pastcompute/sentrifarm/attic/experiments/solar430/logger2.jpg

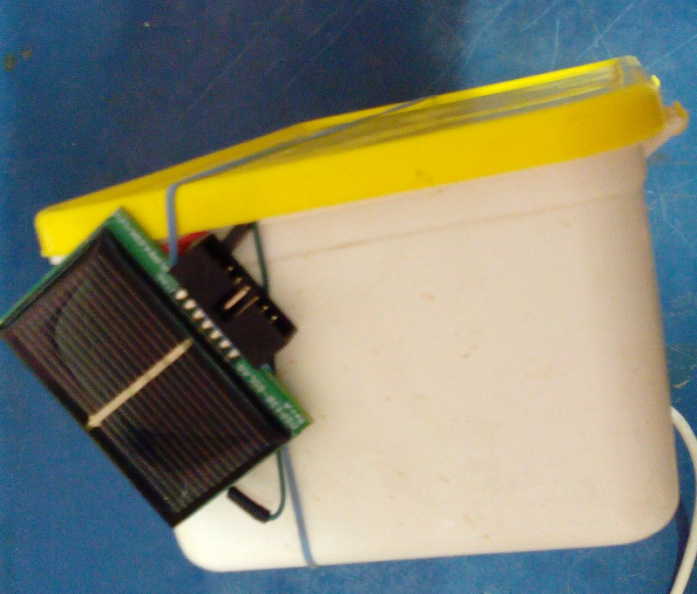
attic/experiments/solar430/logger2.jpg
