pastcompute/sentrifarm/attic/experiments/solar430/logger1.jpg

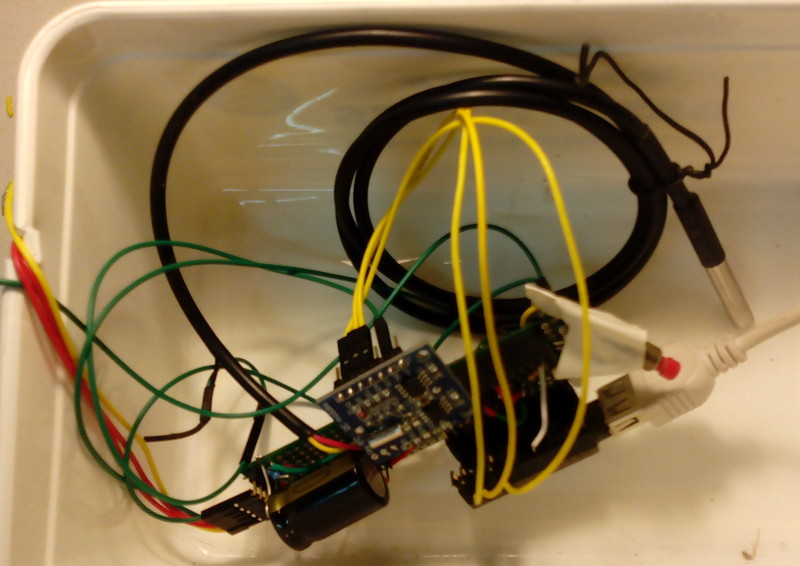
attic/experiments/solar430/logger1.jpg
