pastcompute/sentrifarm/attic/ground-sensor/README.md

# Farmer Stay In bed?

This is the ground sensor subsystem (requirements, schematics, code)
