pastcompute/sentrifarm/attic/frankenstein.md

Needs submnodule. Removed to make gh page in docs/ build

  1 #[submodule "frankenstein"]
  2 #       path = attic/ground-sensor/code/frankenstein
  3 #       url = https://github.com/pastcompute/esp8266-frankenstein.git
