pastcompute/sentrifarm/media/ArtisticImpression.png

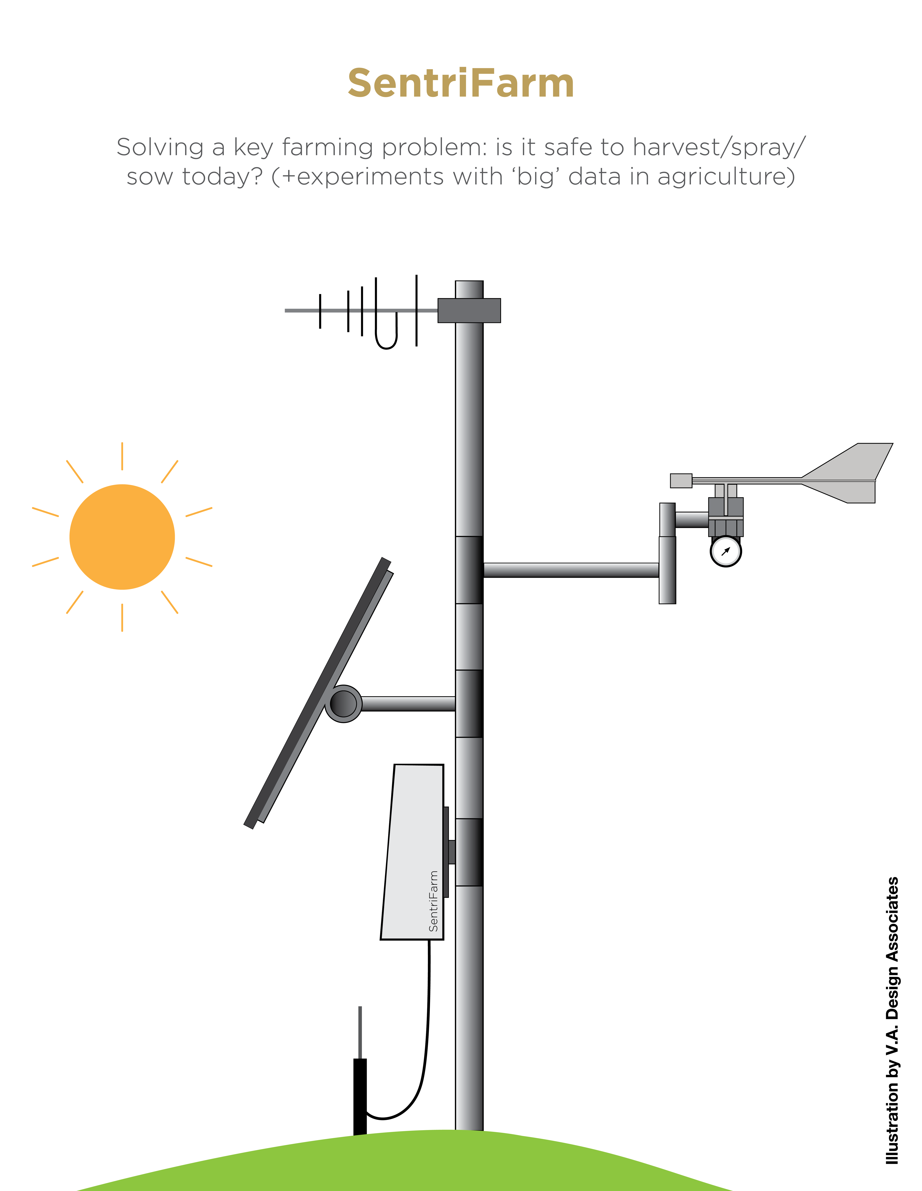
media/ArtisticImpression.png
