pastcompute/sentrifarm/media/birdnest.jpg

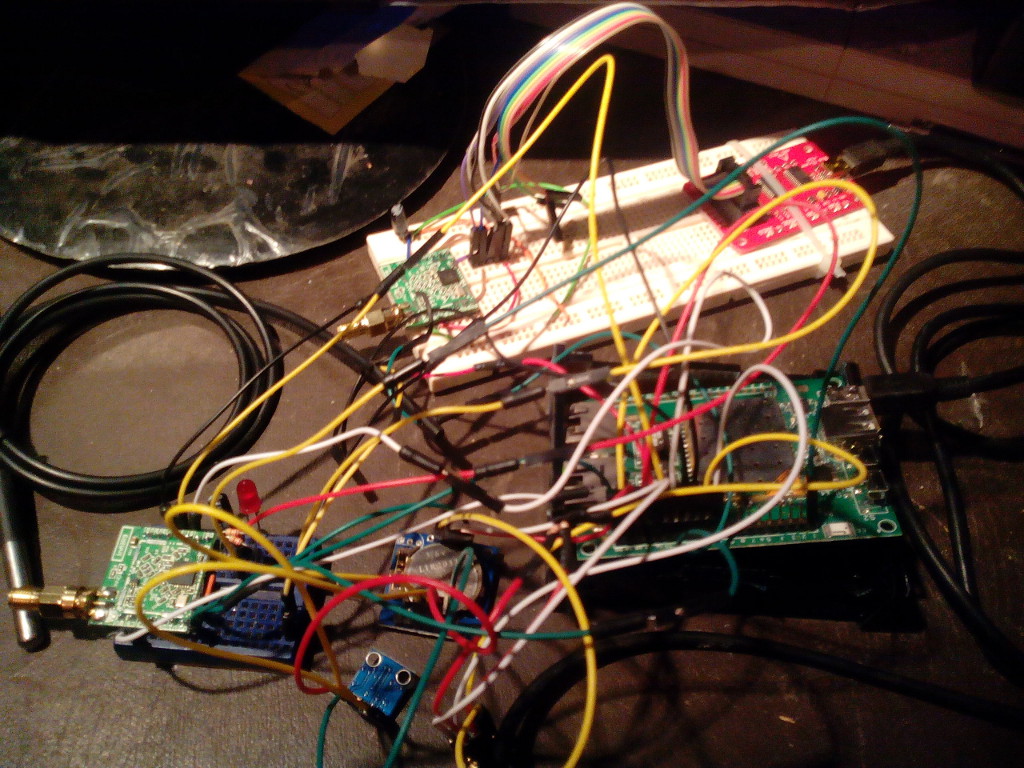
media/birdnest.jpg
