pastcompute/sentrifarm/media/buspirate-sx1276.jpg

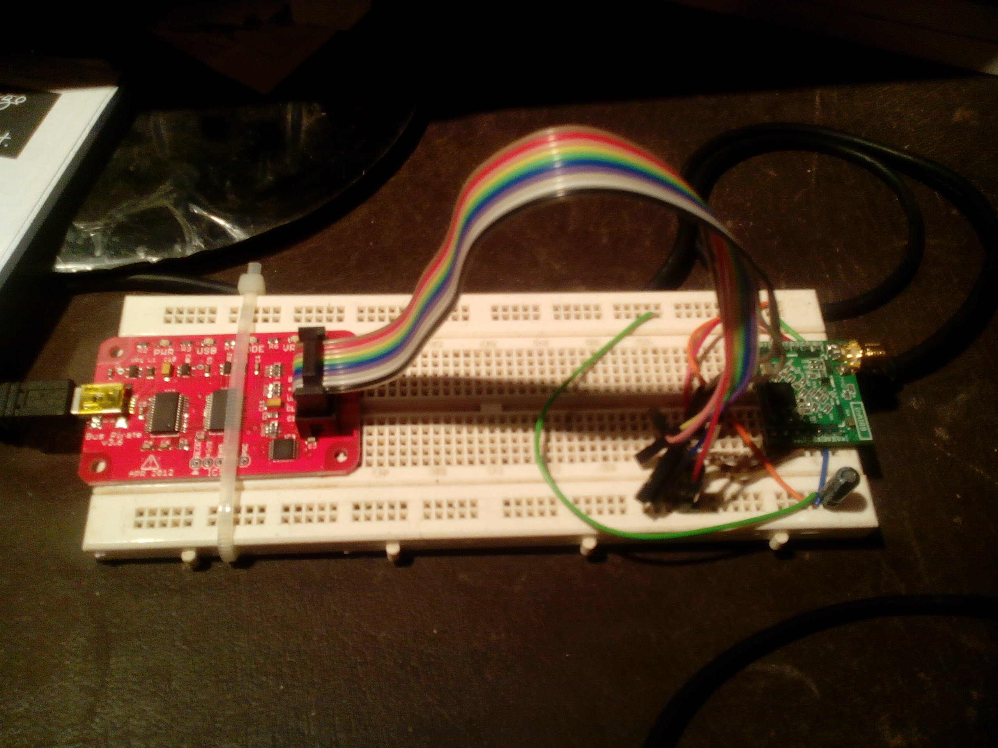
media/buspirate-sx1276.jpg
