pastcompute/sentrifarm/media/HighLevelDesignv0.png

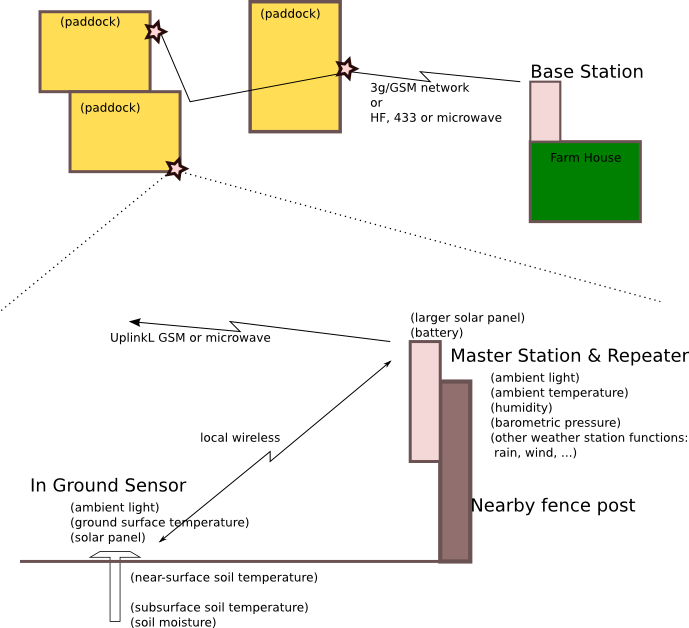
media/HighLevelDesignv0.png
