pastcompute/sentrifarm/attic/experiments/solar430/third-logging-run.ods

 | Time | Vsolar | Vcap | Vregin | Icap mA | Charge | Vregout | TempC
2015-04-10 18:21:13 | 18:21 | 2556 | 2052 | 2057 | 0.13 | 45.14 | 3289 | 16.00
2015-04-10 18:26:13 | 18:26 | 2223 | 2047 | 2038 | -0.23 | 45.03 | 3299 | 15.75
2015-04-10 18:31:13 | 18:31 | 2135 | 2038 | 2033 | -0.13 | 44.84 | 3284 | 15.50
2015-04-10 18:36:14 | 18:36 | 2174 | 2033 | 2023 | -0.26 | 44.73 | 3279 | 15.25
2015-04-10 18:41:14 | 18:41 | 2082 | 2028 | 2018 | -0.26 | 44.62 | 3279 | 15.25
2015-04-10 18:46:14 | 18:46 | 1984 | 2018 | 2008 | -0.26 | 44.40 | 3279 | 15.00
2015-04-10 18:51:14 | 18:51 | 1979 | 2013 | 2003 | -0.26 | 44.29 | 3279 | 15.00
2015-04-10 18:56:15 | 18:56 | 1989 | 2008 | 1999 | -0.23 | 44.18 | 3279 | 15.00
2015-04-10 19:01:15 | 19:01 | 2096 | 2008 | 1994 | -0.36 | 44.18 | 3279 | 14.75
2015-04-10 19:06:15 | 19:06 | 2067 | 1994 | 1984 | -0.26 | 43.87 | 3279 | 14.75
2015-04-10 19:11:16 | 19:11 | 2057 | 1989 | 1979 | -0.26 | 43.76 | 3279 | 14.50
2015-04-10 19:16:16 | 19:16 | 2013 | 1994 | 1974 | -0.51 | 43.87 | 3279 | 14.50
2015-04-10 19:21:16 | 19:21 | 2028 | 1979 | 1969 | -0.26 | 43.54 | 3279 | 14.50
2015-04-10 19:26:16 | 19:26 | 1984 | 1974 | 1959 | -0.38 | 43.43 | 3279 | 14.25
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
