pastcompute/sentrifarm/attic/experiments/solar430/first-logging-run.ods

 | Time |  | Vsolar | Vcap | Vdin | Icap uA | Vreg | Temp
2015-04-04 22:46:29 | 10:46 PM | 10.428 | 0 | 474 | 474 | 0.00 | 474 | 19.75
2015-04-04 22:51:30 | 10:51 PM | 10.516 | 0 | 478 | 478 | 0.00 | 478 | 18.25
2015-04-04 22:56:30 | 10:56 PM | 10.516 | 0 | 478 | 478 | 0.00 | 478 | 17.5
2015-04-04 23:01:30 | 11:01 PM | 10.626 | 0 | 483 | 483 | 0.00 | 483 | 17.25
2015-04-04 23:06:30 | 11:06 PM | 10.626 | 0 | 483 | 483 | 0.00 | 483 | 17
2015-04-04 23:11:31 | 11:11 PM | 10.626 | 0 | 483 | 488 | 73.53 | 483 | 16.75
2015-04-04 23:16:31 | 11:16 PM | 10.626 | 0 | 483 | 488 | 73.53 | 483 | 16.5
2015-04-04 23:21:31 | 11:21 PM | 10.736 | 0 | 488 | 488 | 0.00 | 488 | 16.5
2015-04-04 23:26:32 | 11:26 PM | 10.736 | 0 | 488 | 493 | 73.53 | 488 | 16.25
2015-04-04 23:31:32 | 11:31 PM | 10.736 | 0 | 488 | 493 | 73.53 | 488 | 16
2015-04-04 23:36:32 | 11:36 PM | 10.846 | 0 | 493 | 493 | 0.00 | 488 | 16
2015-04-04 23:41:32 | 11:41 PM | 10.846 | 0 | 493 | 493 | 0.00 | 493 | 15.75
2015-04-04 23:46:33 | 11:46 PM | 10.846 | 0 | 493 | 493 | 0.00 | 493 | 15.75
2015-04-04 23:51:33 | 11:51 PM | 10.846 | 0 | 493 | 498 | 73.53 | 493 | 15.75
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
