pastcompute/sentrifarm/attic/experiments/solar430/second-logging-run.ods

 |  | Vsolar | Vcap | Vregin | Icap mA | Charge | Vregout | TempC
2015-04-10 15:53:41 | 15:53 | 562 | 322 | 371 | 1.26 | 7.08 | 552 | 19.75 | 0.154
2015-04-10 15:54:14 | 15:54 | 2326 | 337 | 2047 | 43.85 | 7.41 | 3274 | 20 | 0.161173913
2015-04-10 15:54:22 | 15:54 | 2326 | 351 | 2043 | 43.38 | 7.72 | 3260 | 20.25 | 0.1678695652
2015-04-10 15:54:50 | 15:54 | 2341 | 410 | 2057 | 42.23 | 9.02 | 3279 | 20.75 | 0.1960869565
2015-04-10 15:55:36 | 15:55 | 2287 | 488 | 2013 | 39.10 | 10.74 | 3235 | 21.5 | 0.2333913043
2015-04-10 15:56:01 | 15:56 | 2292 | 527 | 2033 | 38.62 | 11.59 | 3255 | 22 | 0.2520434783
2015-04-10 15:56:09 | 15:56 | 2306 | 542 | 2038 | 38.36 | 11.92 | 3255 | 22.25 | 0.2592173913
2015-04-10 15:56:13 | 15:56 | 2262 | 547 | 1999 | 37.23 | 12.03 | 3255 | 22.25 | 0.2616086957
2015-04-10 15:56:18 | 15:56 | 2336 | 557 | 2067 | 38.72 | 12.25 | 3250 | 22.25 | 0.2663913043
2015-04-10 15:56:23 | 15:56 | 2321 | 566 | 2062 | 38.36 | 12.45 | 3250 | 22.25 | 0.2706956522
2015-04-10 15:56:29 | 15:56 | 2238 | 576 | 1979 | 35.97 | 12.67 | 3255 | 22.5 | 0.2754782609
2015-04-10 15:56:34 | 15:56 | 2194 | 581 | 1930 | 34.59 | 12.78 | 3235 | 22.5 | 0.2778695652
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
