pastcompute/sentrifarm/attic/experiments/solar430/chart-1.png

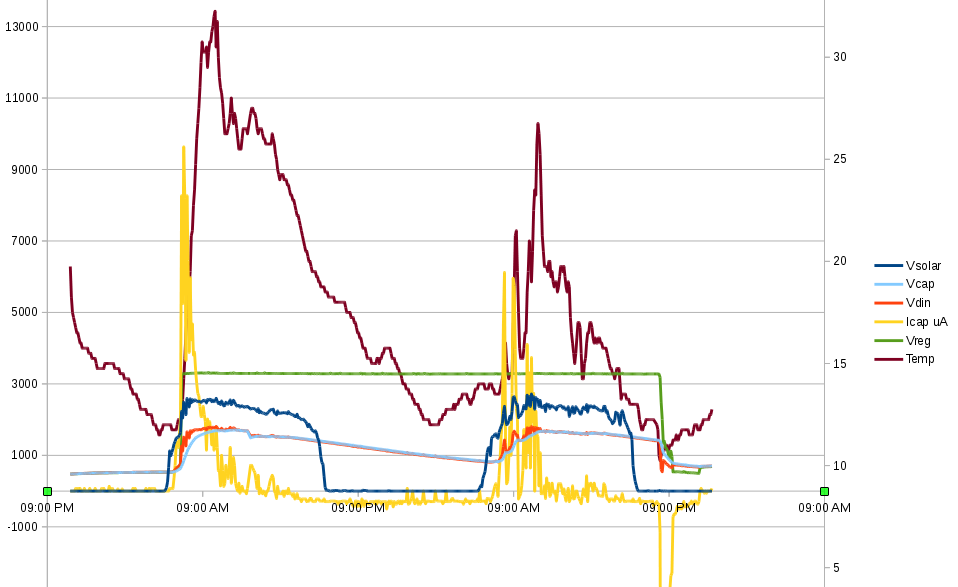
attic/experiments/solar430/chart-1.png
