pastcompute/sentrifarm/attic/experiments/solar430/chart-2a.png

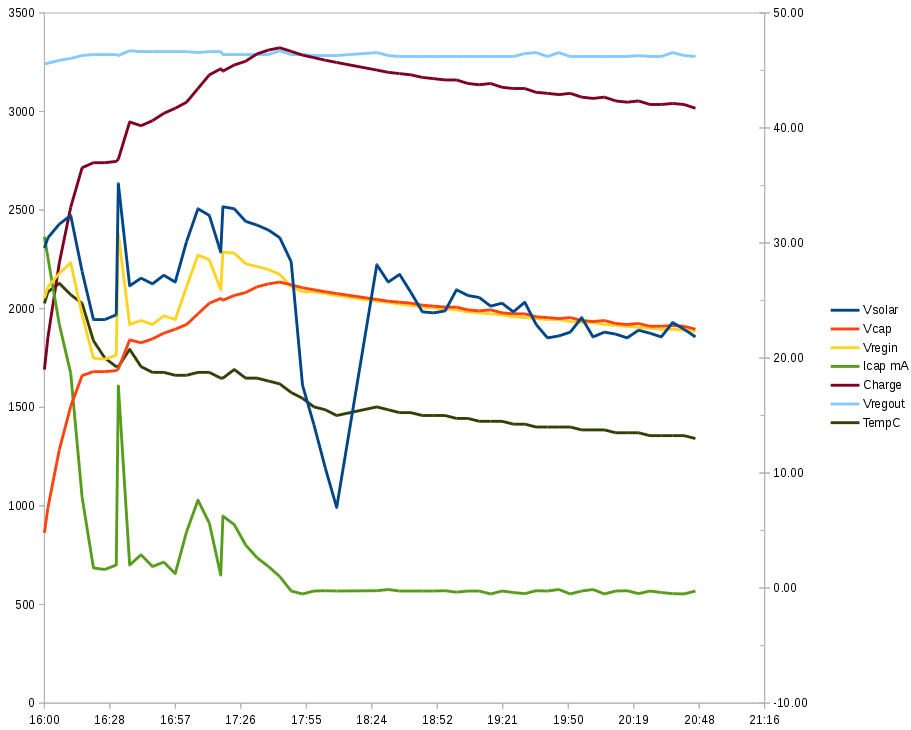
attic/experiments/solar430/chart-2a.png
