pastcompute/sentrifarm/attic/experiments/solar430/chart-3a.png

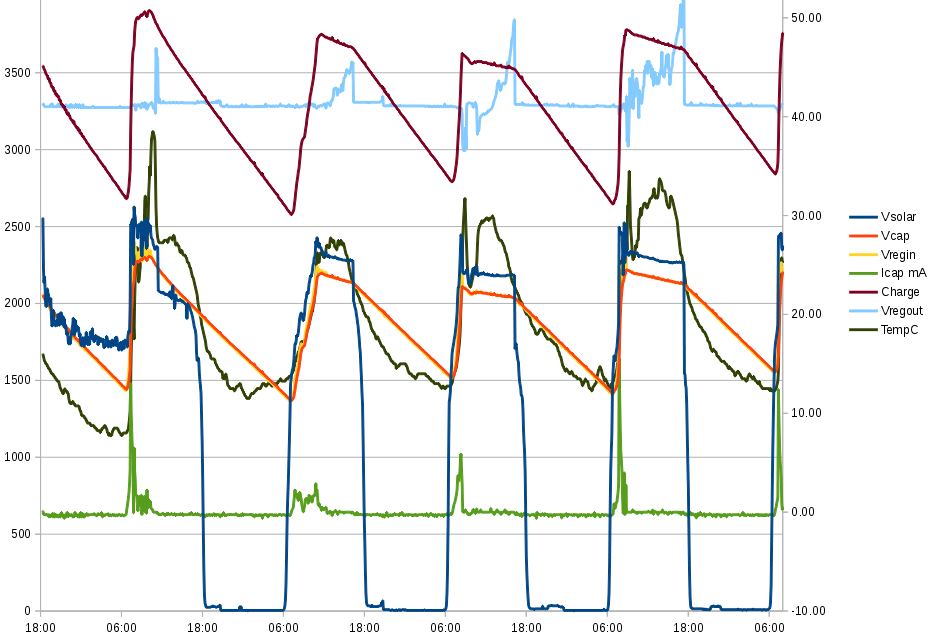
attic/experiments/solar430/chart-3a.png
