pastcompute/sentrifarm/hardware/carambola2-inair9-io-shield/ioshield.pdf

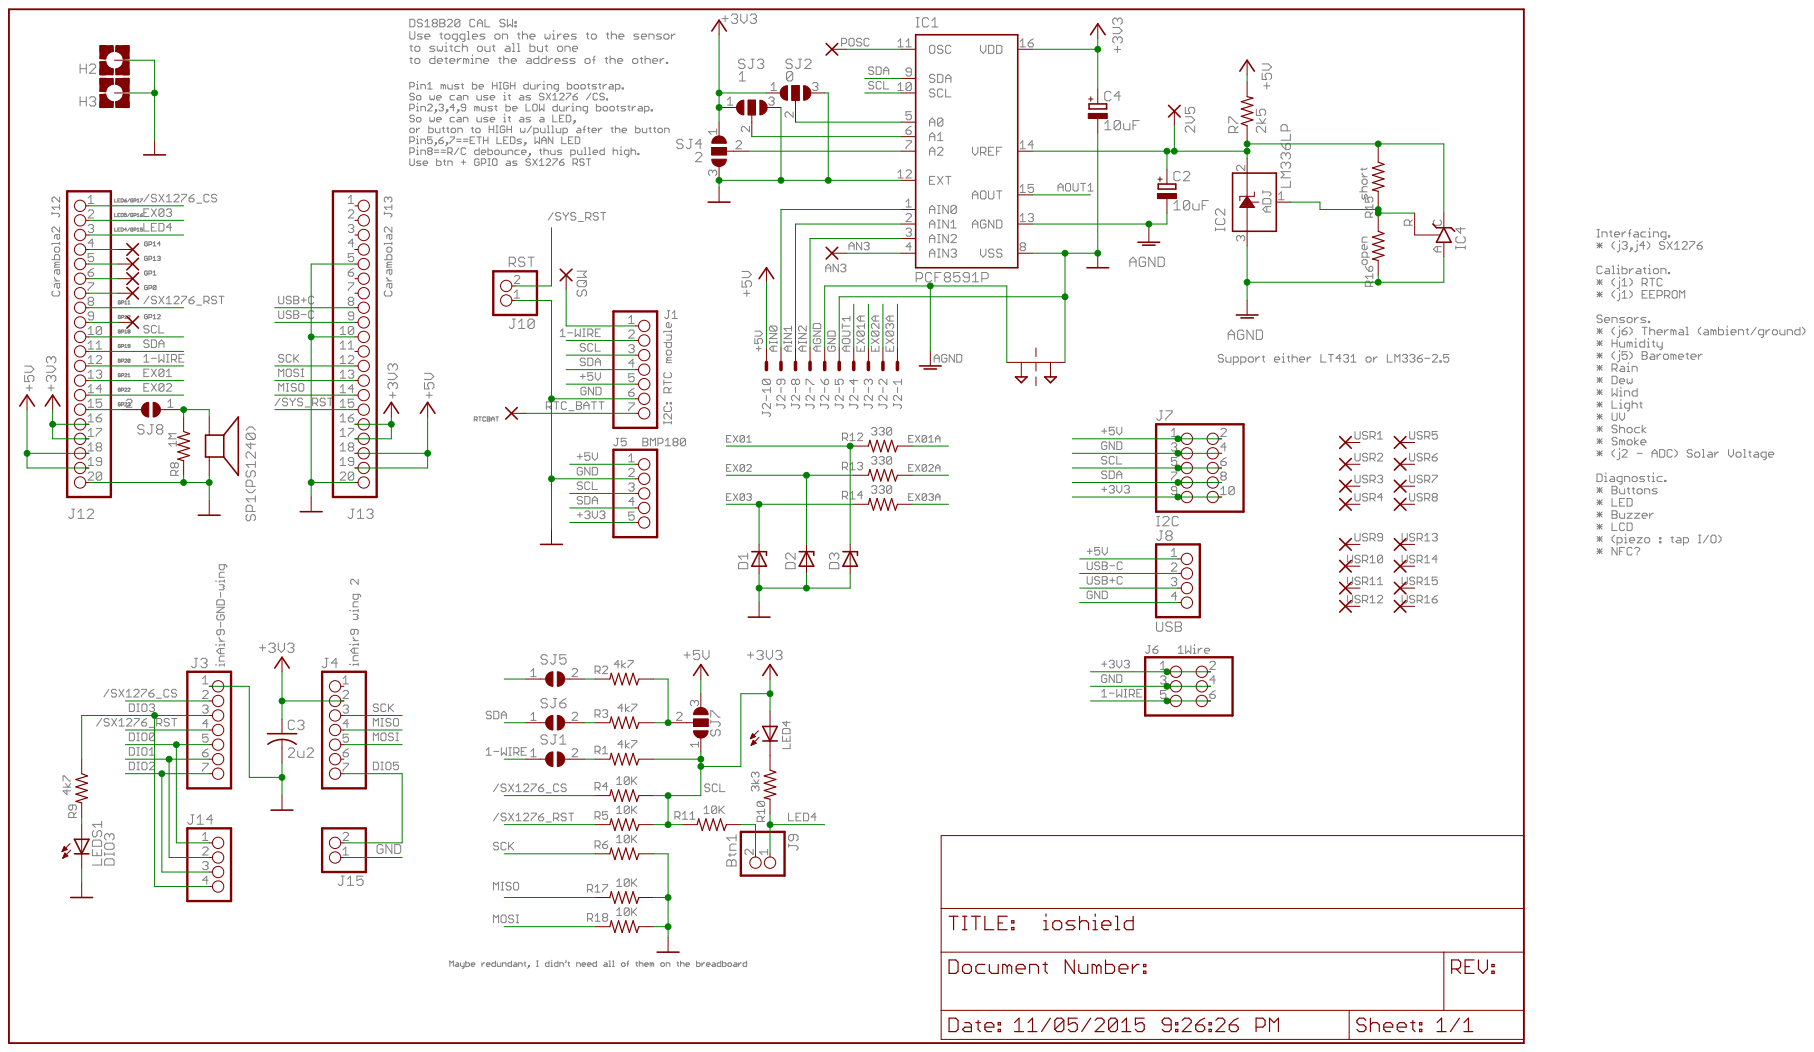
[picture p10: page 1]
