pastcompute/sentrifarm/hardware/inair9-ioshield-adaptor/ioshield.pdf

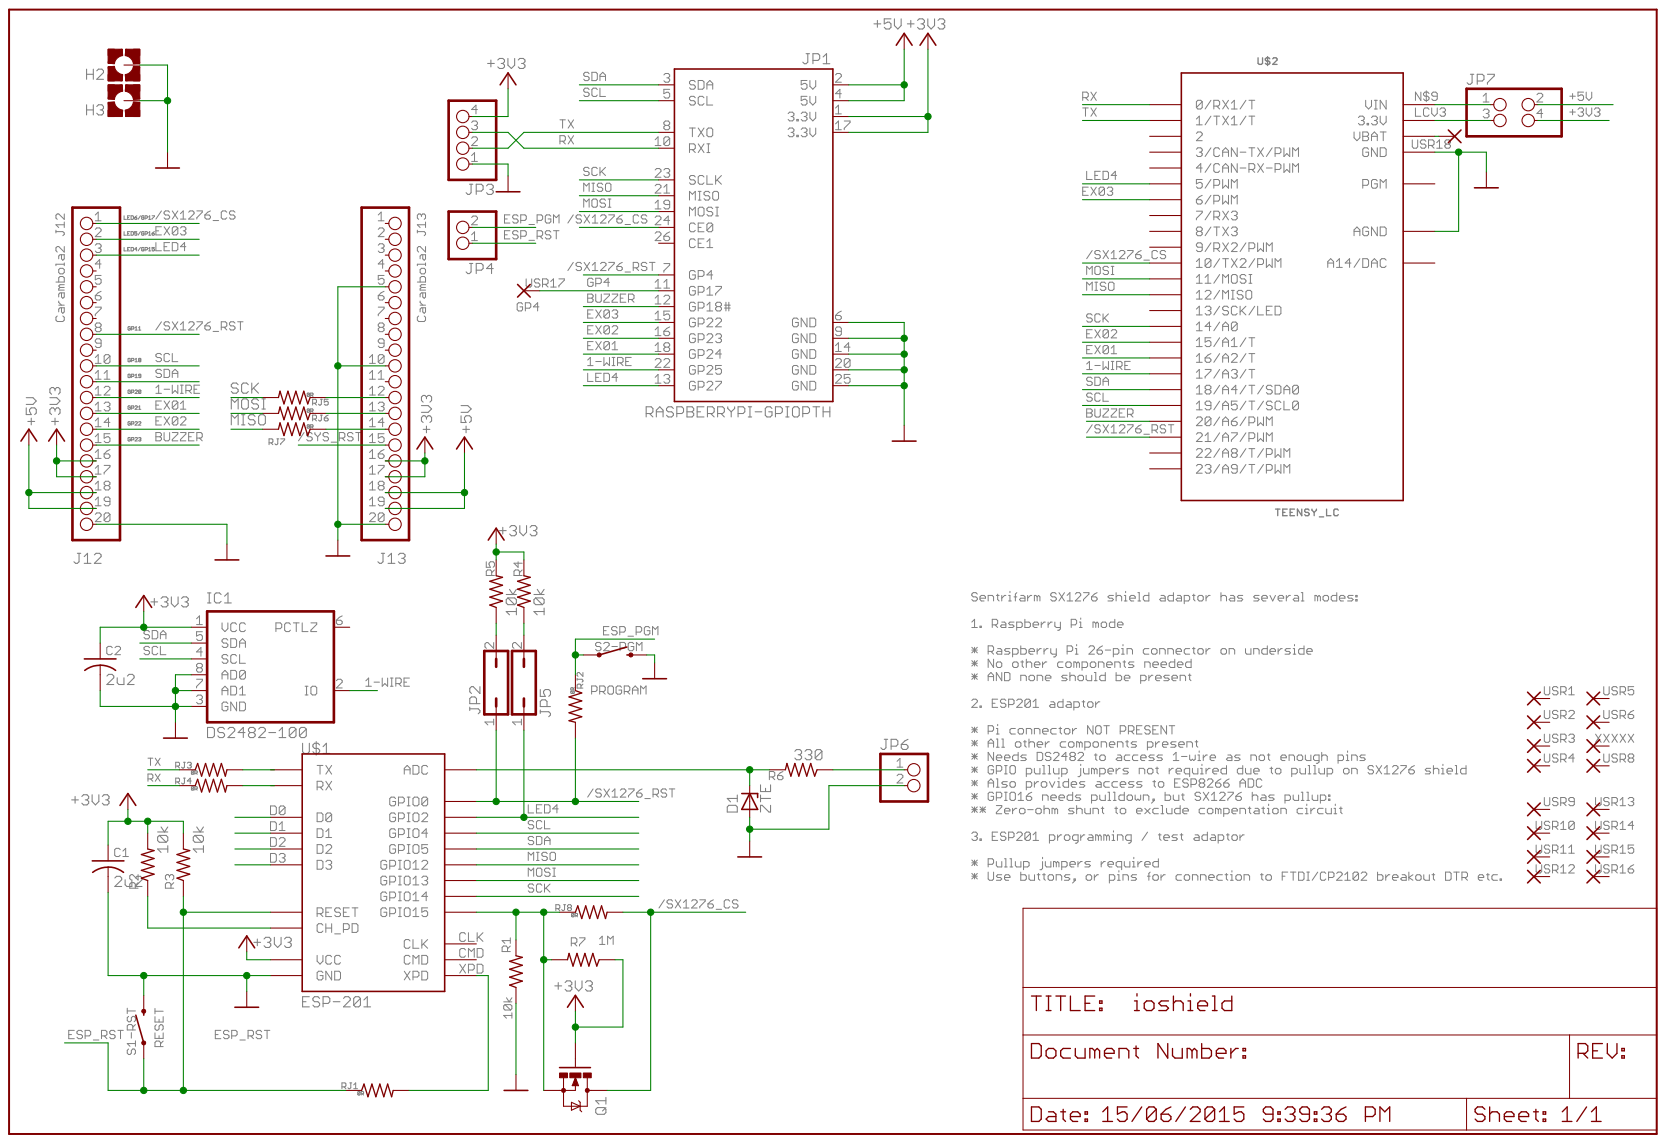
[picture p11: page 1]
