pastcompute/sentrifarm/(list of files, drawings)

Other design files:
attic/experiments/solar430/charge_monitor.fzz
attic/ground-sensor/schematics/esp01-ground-sensor-prototype0-threshold.fzz
attic/ground-sensor/schematics/esp01-simple_temp.fzz
