pastcompute/sentrifarm/hardware/inair9-ioshield-adaptor/ioshield.brd

## EAGLE design hardware/inair9-ioshield-adaptor/ioshield.brd (2015-06-28)

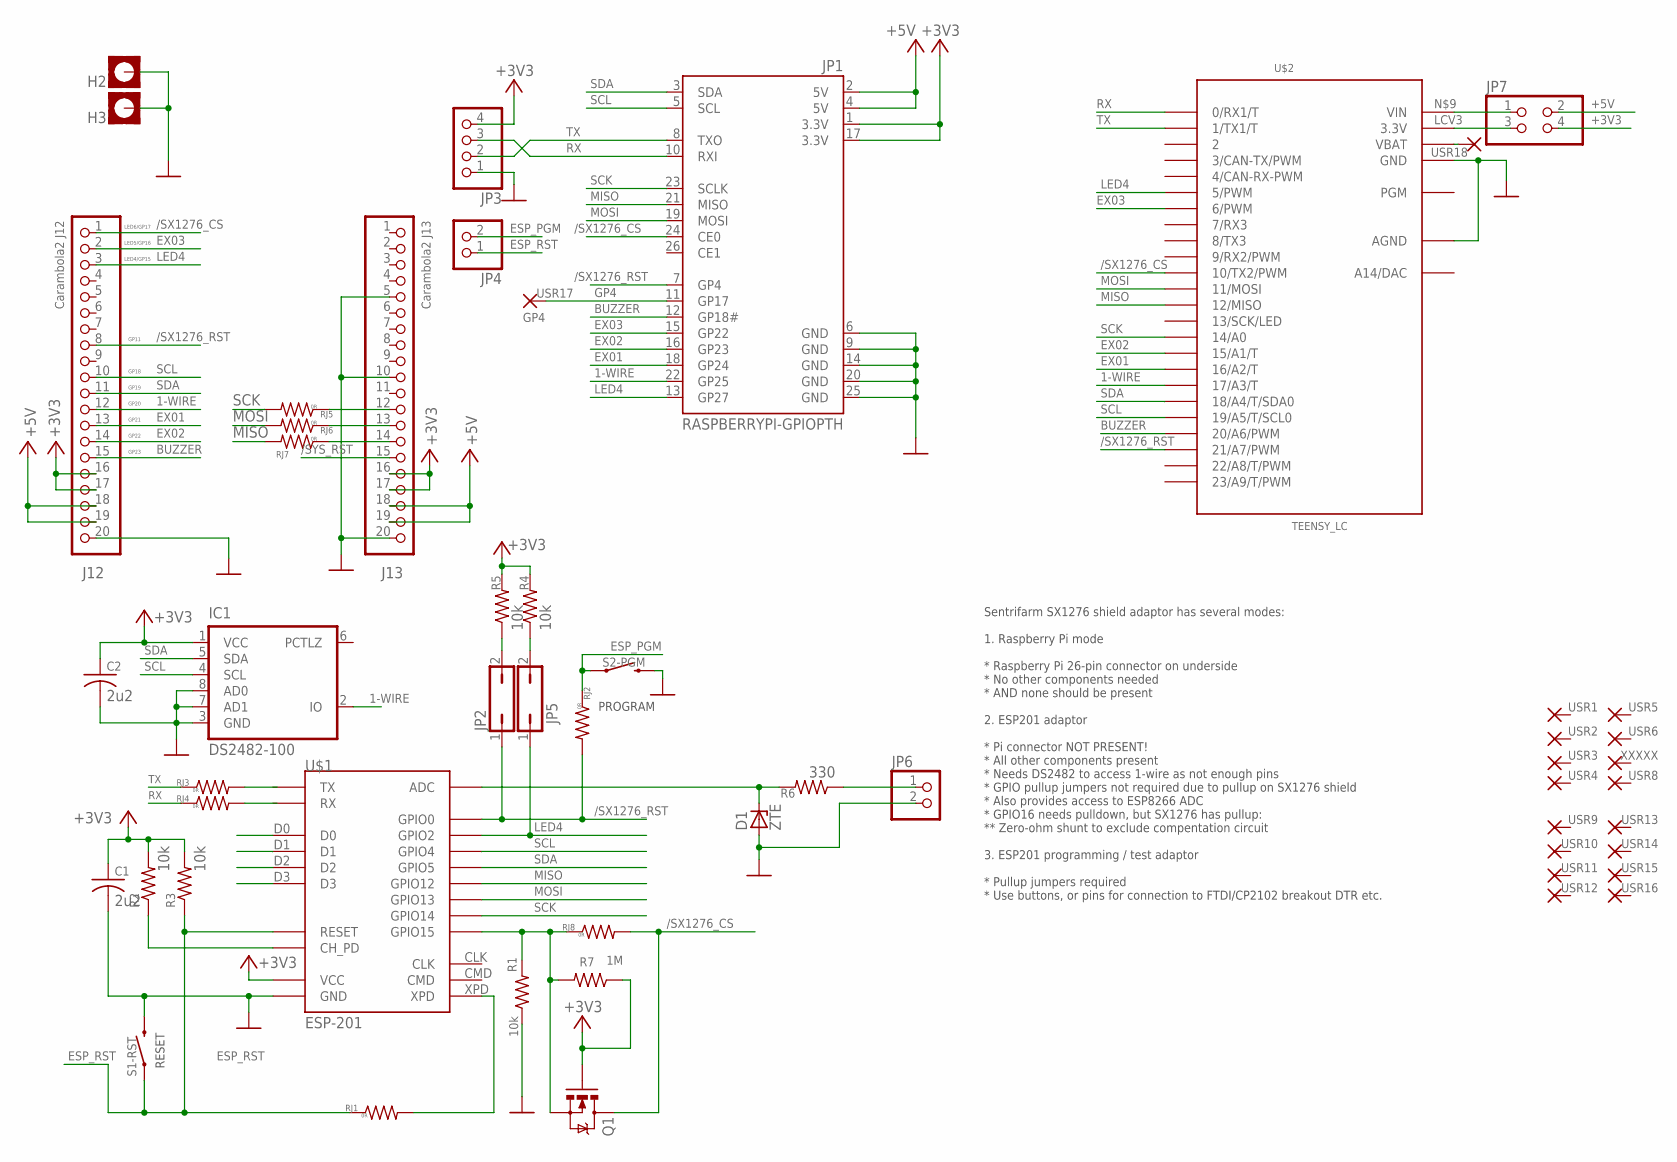
[picture p12: schematic ioshield.sch]

Parts:
C1, C2: 2u2; C1206
D1: ZTE; DO35Z10
H2, H3: MOUNT-PAD-SQUARE3.2; 3,2-PAD-SQUARE
IC1: DS2482-100; SO08
J12: Carambola2 J12; 1X20
J13: Carambola2 J13; 1X20
JP1: RASPBERRYPI-GPIOPTH; 2X13-SHROUDED
JP2, JP5: JP1Q; JP1
JP3: PINHD-1X4; 1X04
JP4, JP6: PINHD-1X2; 1X02
JP7: PINHD-2X2; 2X02
Q1: MOSFET-NCHANNEL2N7000; TO-92
R1, R2, R3, R4, R5: 10k; M1206
R6: 330; M1206
R7: 1M; M1206
RJ1, RJ2, RJ3, RJ4, RJ5, RJ6, RJ7, RJ8: 0R; M1206
S1-RST, S2-PGM: SWITCH-MOMENTARY-2PTH; TACTILE-PTH
U$1: ESP-201
U$2: TEENSY_LC; TEENSY_3.1_BASIC
USR1, USR2, USR3, USR4, USR5, USR6, USR8, USR9, USR10, USR11, USR12, USR13, USR14, USR15, USR16, USR18: 1,6/0,8
USR17: GP4; 1,6/0,8
XXXXX: 1,6/0,8

Connections:
1-WIRE: IC1.2 (IO), J12.12, JP1.22 (GP25), U$2.17/A3 (17/A3/T)
+3V3: C1.1, C2.1, IC1.1 (VCC), J12.16, J12.17, J13.16, J13.17, JP1.1 (3.3V), JP1.17 (3.3V), JP3.4, JP7.4, Q1.2 (G), R2.2, R3.2, R4.2, R5.2, R7.1, U$1.3V3 (VCC), U$1.3V3_2 (VCC), U$1.3V3_3 (VCC)
+5V: J12.18, J12.19, J13.18, J13.19, JP1.2 (5V), JP1.4 (5V), JP7.2
/SX1276_CS: J12.1, JP1.24 (CE0), Q1.3 (D), RJ8.2, U$2.10 (10/TX2/PWM)
/SX1276_RST: J12.8, JP1.7 (GP4), JP2.1, RJ2.2, U$1.GPIO0, U$2.21/A7 (21/A7/PWM)
/SYS_RST: J13.15
BUZZER: J12.15, JP1.12 (GP18#), U$2.20/A6 (20/A6/PWM)
CH_PD: R2.1, U$1.CH_PD
ESP_ADC: D1.C, R6.2, U$1.ADC
ESP_GPIO15: Q1.1 (S), R1.2, R7.2, RJ8.1, U$1.GPIO15
ESP_PGM: JP4.2, RJ2.1, S2-PGM.1
ESP_RST: JP4.1, R3.1, RJ1.1, S1-RST.1, U$1.RST (RESET)
EX01: J12.13, JP1.18 (GP24), U$2.16/A2 (16/A2/T)
EX02: J12.14, JP1.16 (GP23), U$2.15/A1 (15/A1/T)
EX03: J12.2, JP1.15 (GP22), U$2.6 (6/PWM)
GND: C1.2, C2.2, D1.A, H2.B3,2, H3.B3,2, IC1.3 (GND), IC1.7 (AD1), IC1.8 (AD0), J12.20, J13.5, J13.10, J13.20, JP1.6 (GND), JP1.9 (GND), JP1.14 (GND), JP1.20 (GND), JP1.25 (GND), JP3.1, JP6.2, R1.1, S1-RST.3 (2), S2-PGM.3 (2), U$1.GND, U$1.GND_2 (GND), U$1.GND_3 (GND), U$2.AGND, U$2.GND, U$2.GND1 (GND)
GP4: JP1.11 (GP17), USR17.1
LCV3: JP7.3, U$2.3.3V, U$2.3.3V1 (3.3V)
LED4: J12.3, JP1.13 (GP27), JP5.1, U$1.GPIO2, U$2.5 (5/PWM)
MISO: JP1.21 (MISO), RJ7.2, U$1.GPIO12, U$2.12 (12/MISO)
MOSI: JP1.19 (MOSI), RJ6.2, U$1.GPIO13, U$2.11 (11/MOSI)
unnamed: JP2.2, R5.1
unnamed: JP5.2, R4.1
unnamed: JP6.1, R6.1
unnamed: U$2.VBAT, USR18.1
unnamed: JP7.1, U$2.VIN
NXXX1: J13.12, RJ5.1
NXXX2: J13.13, RJ6.1
NXXX3: J13.14, RJ7.1
RX: JP1.10 (RXI), JP3.3, RJ4.1, U$2.0 (0/RX1/T)
SCK: JP1.23 (SCLK), RJ5.2, U$1.GPIO14, U$2.14/A0
SCL: IC1.4 (SCL), J12.10, JP1.5 (SCL), U$1.GPIO4, U$2.19/A5 (19/A5/T/SCL0)
SDA: IC1.5 (SDA), J12.11, JP1.3 (SDA), U$1.GPIO5, U$2.18/A4 (18/A4/T/SDA0)
TX: JP1.8 (TXO), JP3.2, RJ3.1, U$2.1 (1/TX1/T)
XPD: RJ1.2, U$1.XPD

Notes on the sheet:
LED6/GP17
GP18
GP19
GP20
GP21
GP22
GP23
LED5/GP16
LED4/GP15
GP11
Sentrifarm SX1276 shield adaptor has several modes: 1. Raspberry Pi mode * Raspberry Pi 26-pin connector on underside * No other components needed * AND none should be present 2. ESP201 adaptor * Pi connector NOT PRESENT! * All other components present * Needs DS2482 to access 1-wire as not enough 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
PROGRAM
RESET

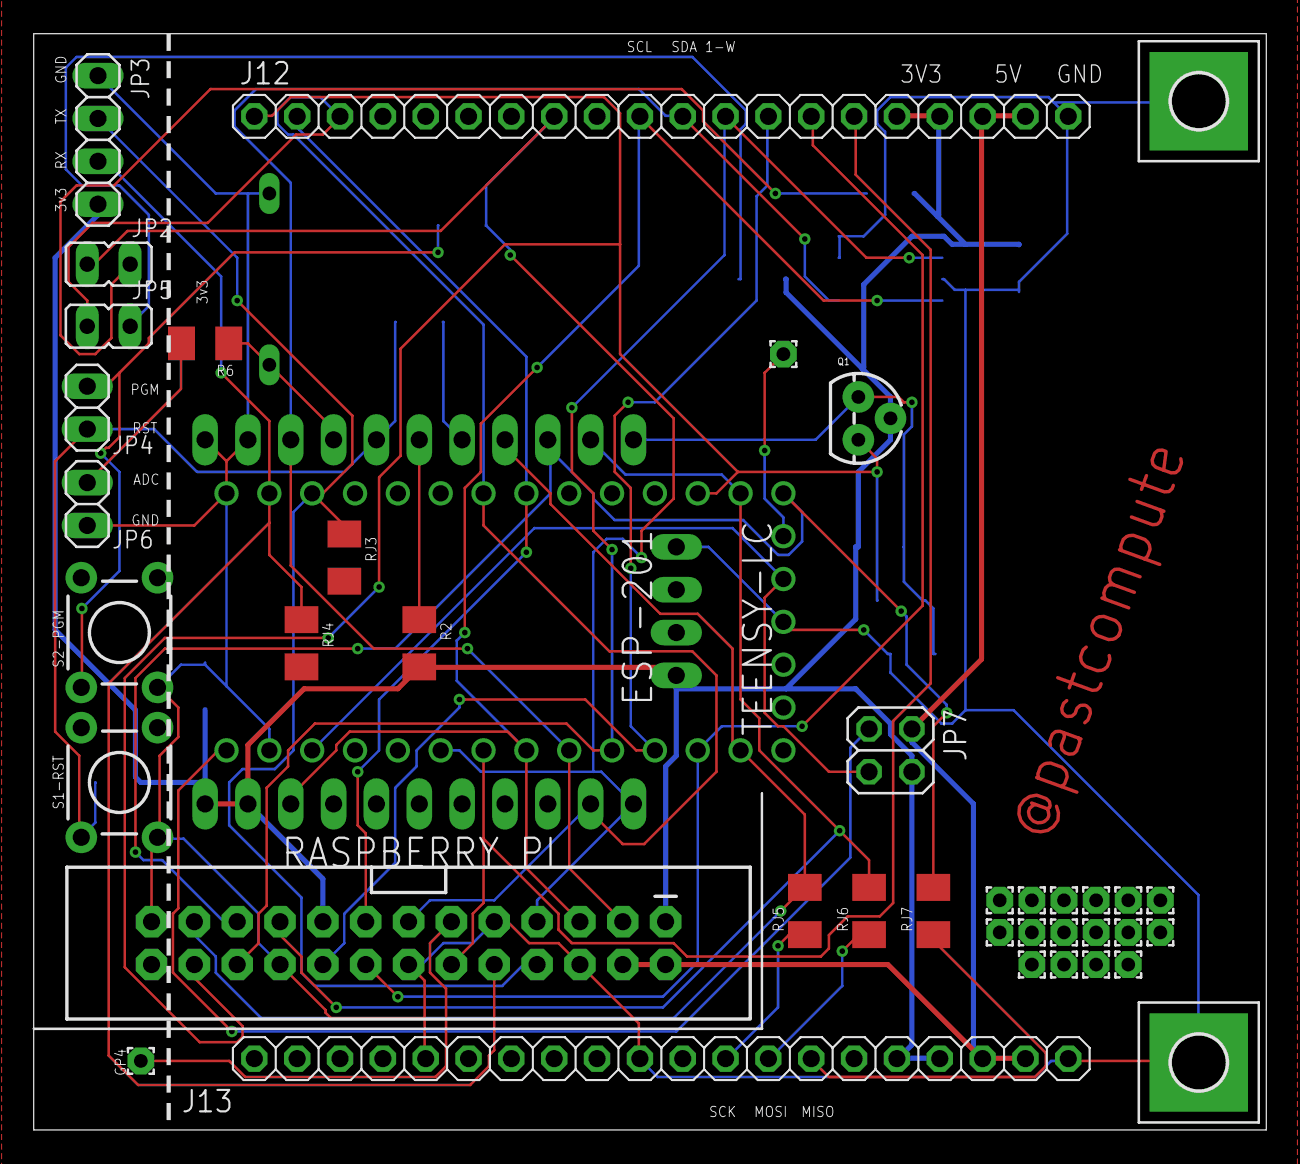
[picture p13: board hardware/inair9-ioshield-adaptor/ioshield.brd from above]

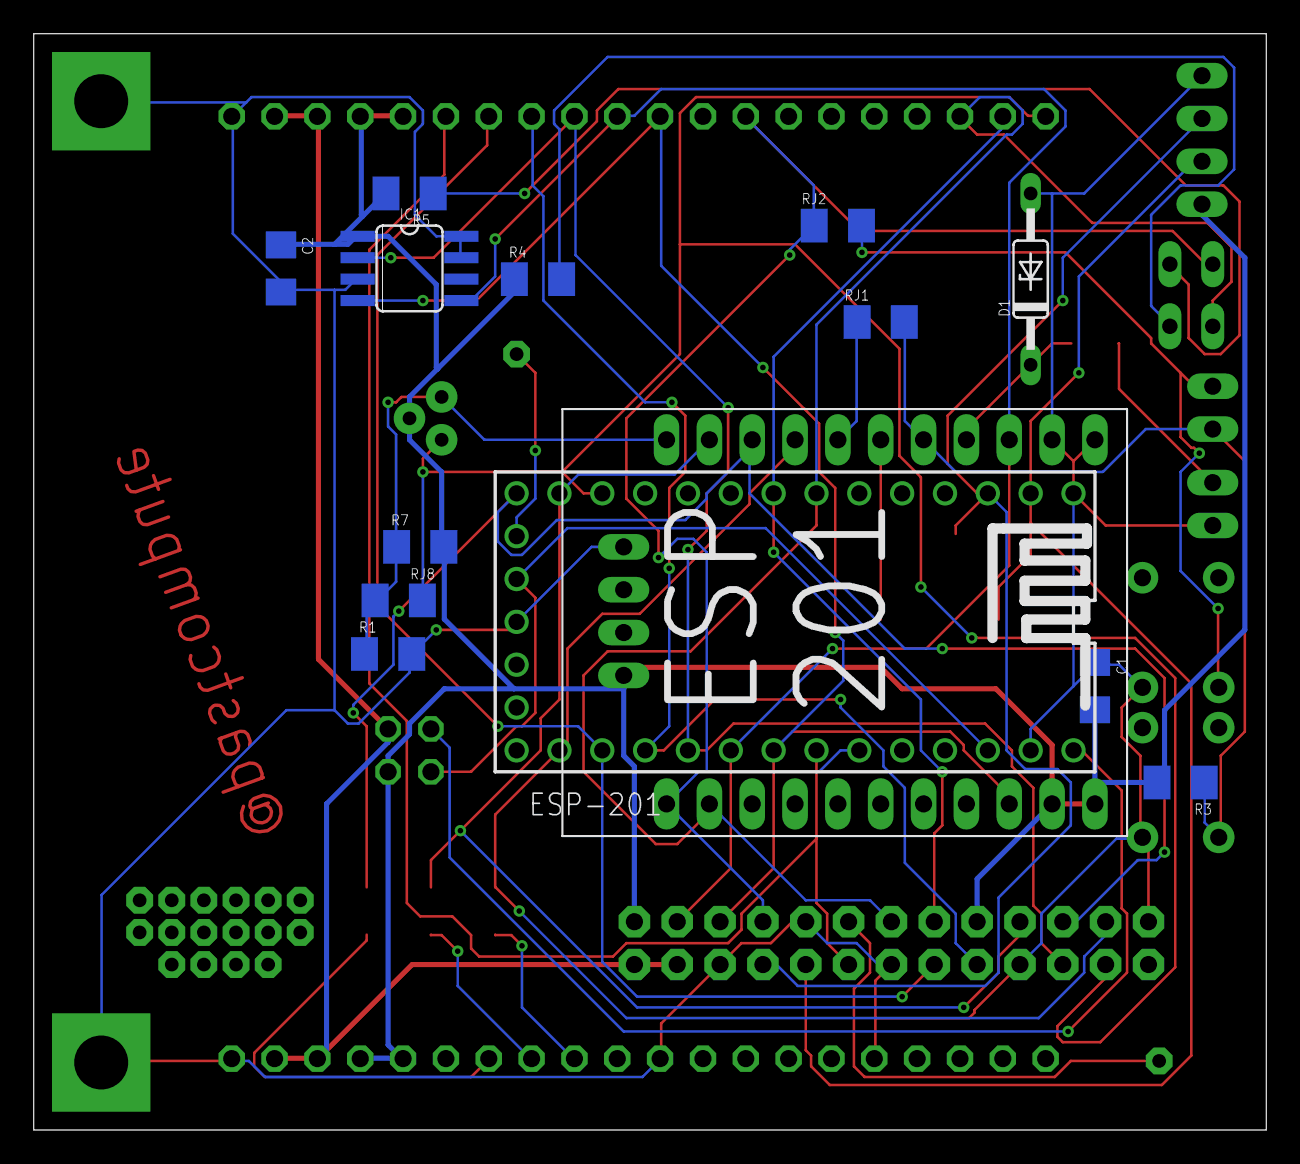
[picture p14: board hardware/inair9-ioshield-adaptor/ioshield.brd from below]

Board: 2 copper layers, 73.1 x 65.0 mm, 53 parts (14 on the bottom side), 34 nets.
