pastcompute/sentrifarm/hardware/carambola2-inair9-io-shield/ioshield.brd

## EAGLE design hardware/carambola2-inair9-io-shield/ioshield.brd (2015-05-12)

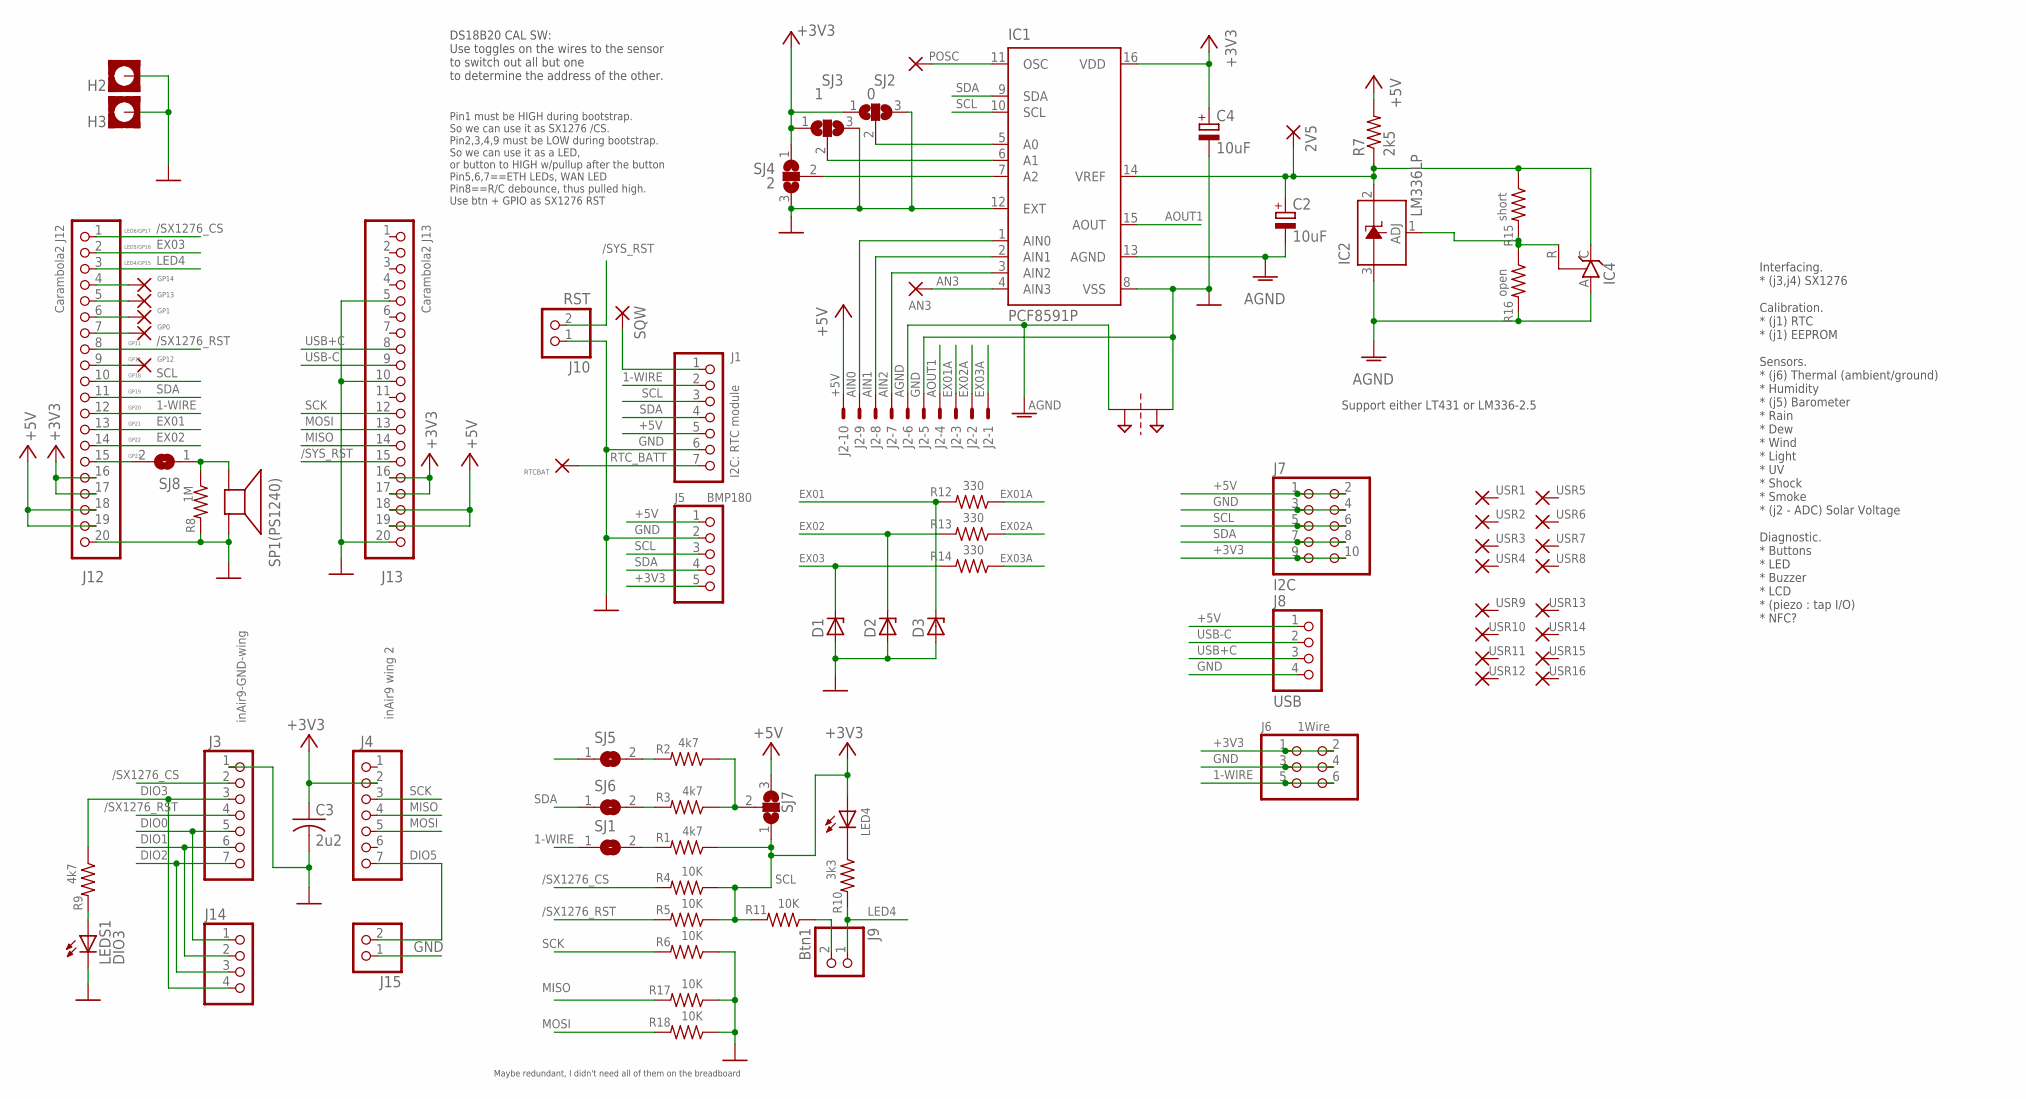
[picture p15: schematic ioshield.sch]

Parts:
2V5: 2,54/0,8
AN3: AN3; 2,54/0,8
C2, C4: 10uF; E2,5-5
C3: 2u2; C1206
D1, D2, D3: ZENER-DIODEZD-2.5; ZDIO-2.5
GP0, GP1, GP12, GP13, GP14: 2,54/0,8
H2, H3: MOUNT-PAD-SQUARE3.2; 3,2-PAD-SQUARE
IC1: PCF8591P; DIL16
IC2: LM336LP; TO92
IC4: TL431CLP; TO92-CLP
J1: I2C: RTC module; 1X07
J2: 22-23-2101; MPN Screw Terminal
J3: inAir9-GND-wing; 1X07
J4: inAir9 wing 2; 1X07
J5: BMP180; 1X05
J6: 1Wire; 2X03
J7: I2C; 2X05
J8: USB; 1X04
J9: Btn1; 1X02
J10: RST; 1X02
J12: Carambola2 J12; 1X20
J13: Carambola2 J13; 1X20
J14: PINHD-1X4; 1X04
J15: PINHD-1X2; 1X02
LED4: LED3MM
LEDS1: DIO3; LED3MM
POSC: 2,54/0,8
PT1: 2PT_GND_TIE
R1, R2, R3, R9: 4k7; M1206
R4, R5, R6, R11, R17, R18: 10K; M1206
R7: 2k5; M1206
R8: 1M; M1206
R10: 3k3; M1206
R12, R13, R14: 330; M1206
R15: short; M1206
R16: open; M1206
RTCBAT: 2,54/0,8
SJ1, SJ5, SJ6, SJ8: SJ
SJ2: 0; SJ_2
SJ3: 1; SJ_2
SJ4: 2; SJ_2
SJ7: SJ2W; SJ_2
SP1(PS1240): SPEAKER/AL11P; AL11P
SQW: 2,54/0,8
USR1, USR2, USR3, USR4, USR5, USR6, USR7, USR8, USR9, USR10, USR11, USR12, USR13, USR14, USR15, USR16: 1,6/0,8

Connections:
1-WIRE: J1.2, J6.5, J6.6, J12.12, SJ1.1
+3V3: C3.1, C4.+, IC1.16 (VDD), J4.2, J5.5, J6.1, J6.2, J7.9, J7.10, J12.16, J12.17, J13.16, J13.17, LED4.A, R1.1, R4.1, R5.1, R11.2, SJ2.1, SJ3.1, SJ4.1, SJ7.1
+5V: J1.5, J2.10, J5.1, J7.1, J7.2, J8.1, J12.18, J12.19, J13.18, J13.19, R7.2, SJ7.3
/SX1276_CS: J3.2, J12.1, R4.2
/SX1276_RST: J3.4, J12.8, R5.2
/SYS_RST: J10.2, J13.15
AGND: C2.-, IC1.13 (AGND), IC2.3 (A), IC4.A, J2.6, PT1.P$1, R16.2
AIN0: IC1.1 (AIN0), J2.9
AIN1: IC1.2 (AIN1), J2.8
AIN2: IC1.3 (AIN2), J2.7
AIN3: AN3.1, IC1.4 (AIN3)
AOUT1: IC1.15 (AOUT), J2.4
DIO0: J3.5, J14.1
DIO1: J3.6, J14.2
DIO2: J3.7, J14.3
DIO3: J3.3, J14.4, R9.1
DIO5: J4.7, J15.2
EX01: D3.C, J12.13, R12.2
EX01A: J2.3, R12.1
EX02: D2.C, J12.14, R13.2
EX02A: J2.2, R13.1
EX03: D1.C, J12.2, R14.2
EX03A: J2.1, R14.1
GND: C3.2, C4.-, D1.A, D2.A, D3.A, H2.B3,2, H3.B3,2, IC1.8 (VSS), IC1.12 (EXT), J1.6, J2.5, J3.1, J5.2, J6.3, J6.4, J7.3, J7.4, J8.4, J10.1, J12.20, J13.5, J13.10, J13.20, J15.1, LEDS1.K (C), PT1.P$2, R6.1, R8.2, R17.1, R18.1, SJ2.3, SJ3.3, SJ4.3, SP1(PS1240).-
LED4: J9.1, J12.3, R10.2
MISO: J4.4, J13.14, R17.2
MOSI: J4.5, J13.13, R18.2
unnamed: IC2.1 (ADJ), IC4.R, R15.2, R16.1
unnamed: R2.1, R3.1, SJ7.2
unnamed: IC1.11 (OSC), POSC.1
unnamed: J9.2, R11.1
unnamed: R1.2, SJ1.2
unnamed: GP12.1, J12.9
unnamed: GP14.1, J12.4
unnamed: R2.2, SJ5.2
unnamed: R8.1, SJ8.1, SP1(PS1240).+
unnamed: IC1.7 (A2), SJ4.2
unnamed: R3.2, SJ6.2
unnamed: GP0.1, J12.7
unnamed: LED4.K (C), R10.1
unnamed: J1.1, SQW.1
unnamed: IC1.5 (A0), SJ2.2
unnamed: LEDS1.A, R9.2
unnamed: J12.15, SJ8.2
unnamed: IC1.6 (A1), SJ3.2
unnamed: GP1.1, J12.6
unnamed: GP13.1, J12.5
RTC_BATT: J1.7, RTCBAT.1
SCK: J4.3, J13.12, R6.2
SCL: IC1.10 (SCL), J1.3, J5.3, J7.5, J7.6, J12.10, SJ5.1
SDA: IC1.9 (SDA), J1.4, J5.4, J7.7, J7.8, J12.11, SJ6.1
USB+C: J8.3, J13.8
USB-C: J8.2, J13.9
VREF2V5: 2V5.1, C2.+, IC1.14 (VREF), IC2.2 (C), IC4.C, R7.1, R15.1

Notes on the sheet:
LED6/GP17
GP18
GP19
GP20
Interfacing. * (j3,j4) SX1276 Calibration. * (j1) RTC * (j1) EEPROM Sensors. * (j6) Thermal (ambient/ground) * Humidity * (j5) Barometer * Rain * Dew * Wind * Light * UV * Shock * Smoke * (j2 - ADC) Solar Voltage Diagnostic. * Buttons * LED * Buzzer * LCD * (piezo : tap I/O) * NFC?
DS18B20 CAL SW: Use toggles on the wires to the sensor to switch out all but one to determine the address of the other.
Pin1 must be HIGH during bootstrap. So we can use it as SX1276 /CS. Pin2,3,4,9 must be LOW during bootstrap. So we can use it as a LED, or button to HIGH w/pullup after the button Pin5,6,7==ETH LEDs, WAN LED Pin8==R/C debounce, thus pulled high. Use btn + GPIO as SX1276 RST
GP21
GP22
GP23
LED5/GP16
LED4/GP15
GP11
GP12
Support either LT431 or LM336-2.5
Maybe redundant, I didn't need all of them on the breadboard

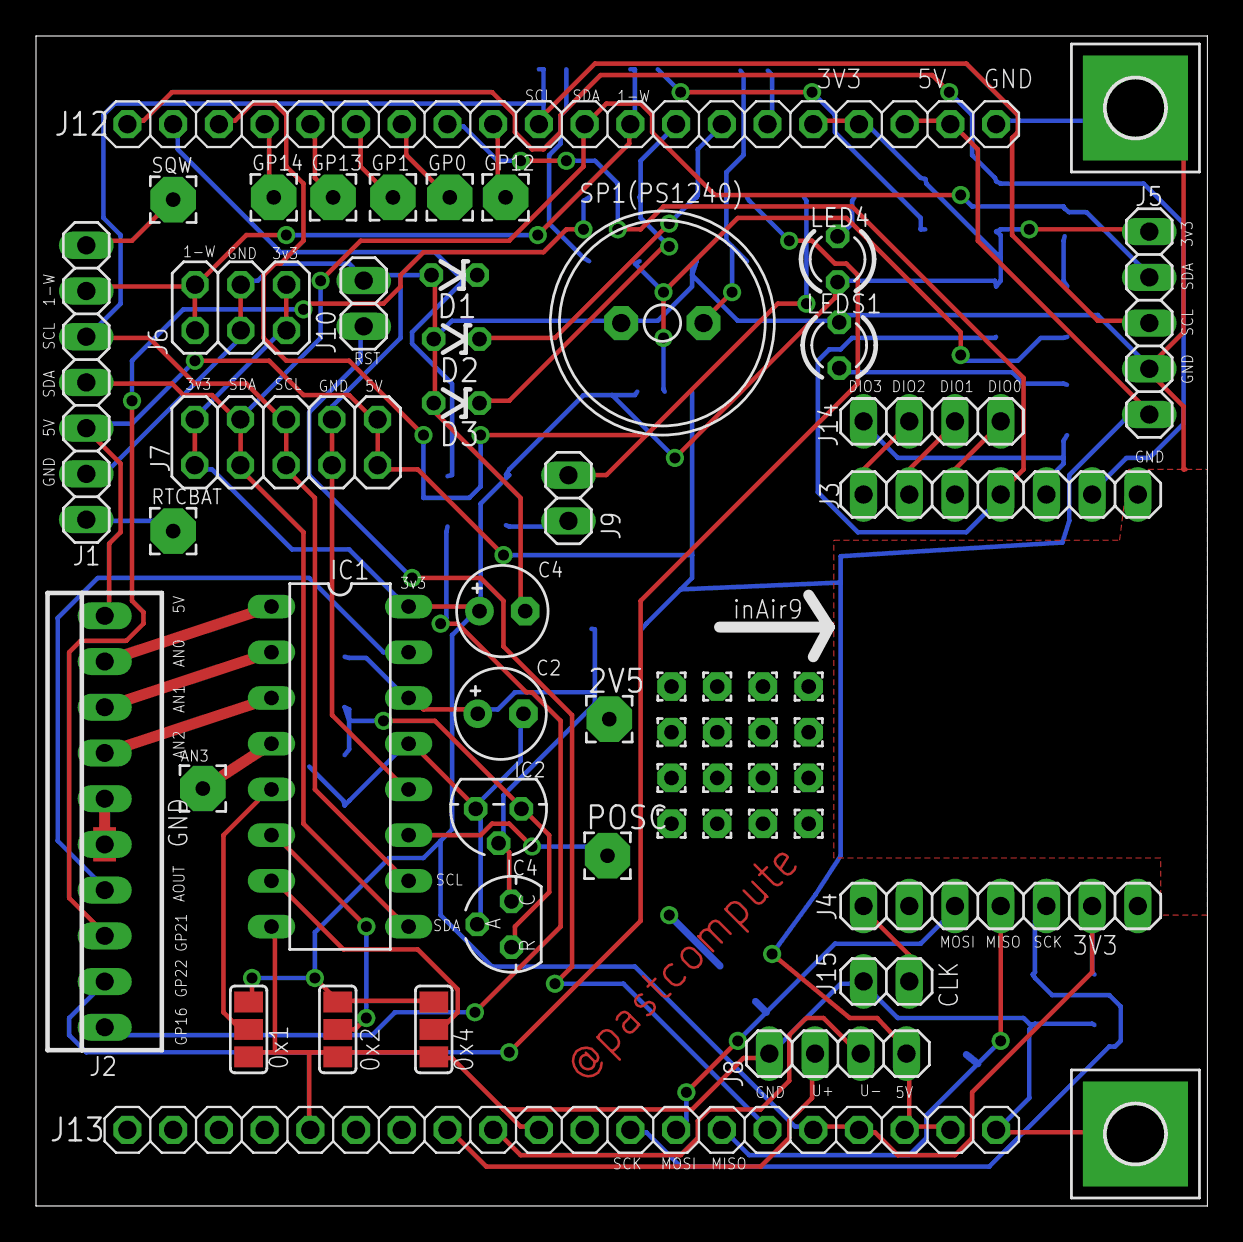
[picture p16: board hardware/carambola2-inair9-io-shield/ioshield.brd from above]

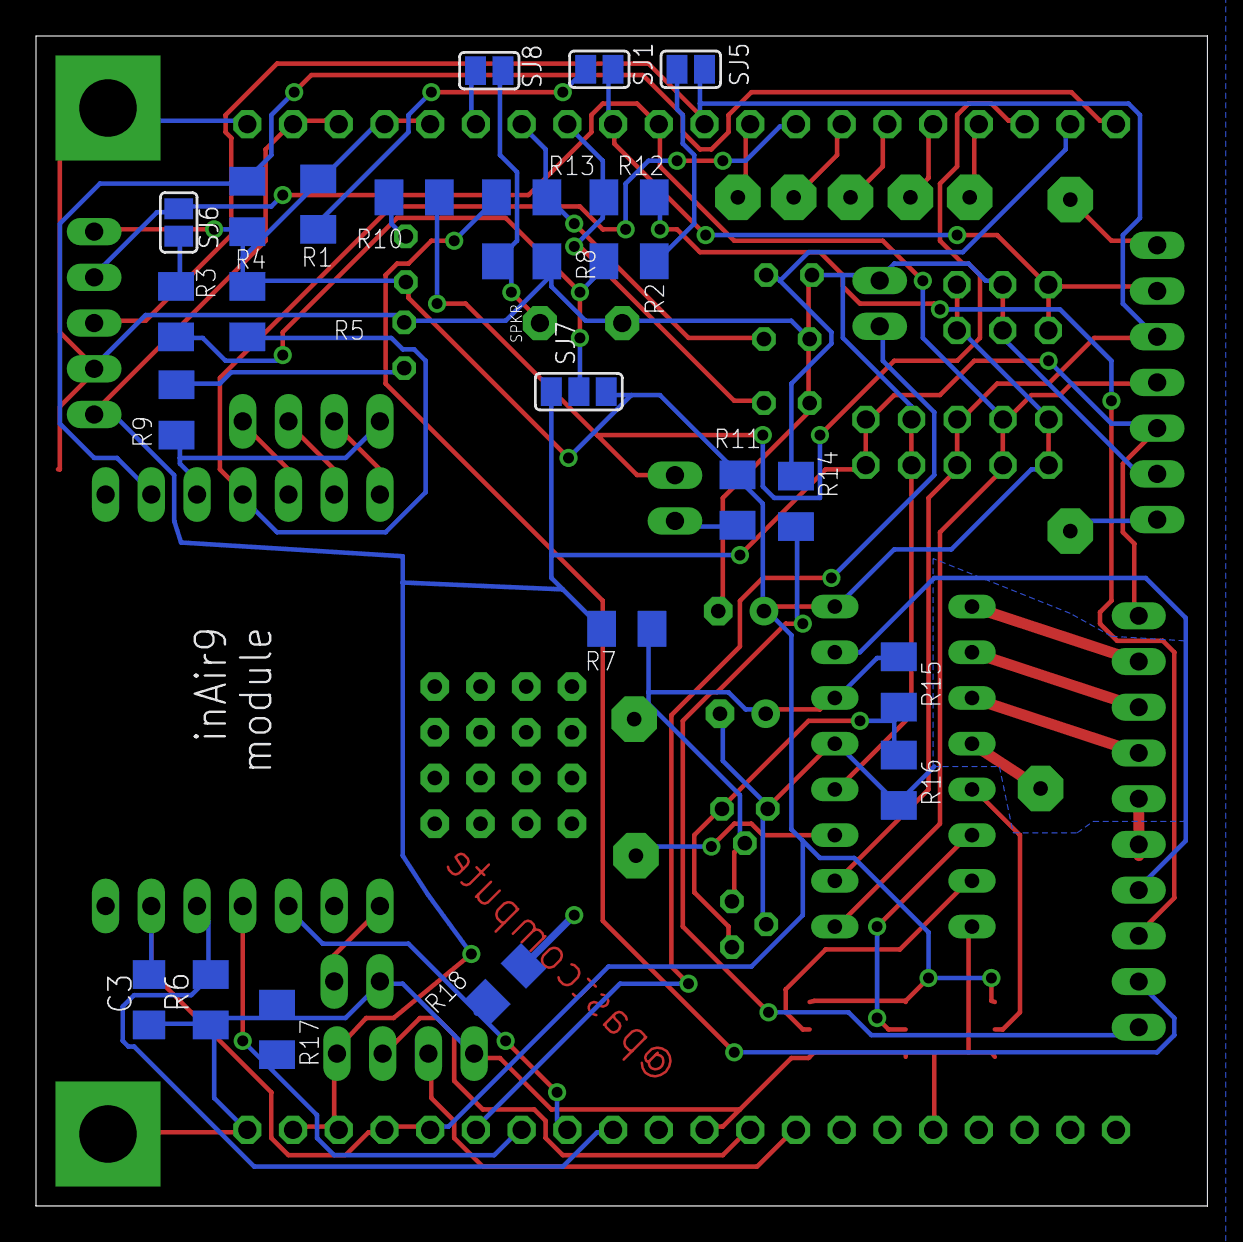
[picture p17: board hardware/carambola2-inair9-io-shield/ioshield.brd from below]

Board: 2 copper layers, 65.1 x 65.0 mm, 81 parts (24 on the bottom side), 54 nets.
