pastcompute/sentrifarm/software/openwrt/files/etc/sentrifarm-rsmb-config.txt

trace_output protocol
#trace_output stderr
#trace_level maximum
log_level detail
#log_level config
listener 1883 INADDR_ANY mqtts
listener 1883 INADDR_ANY
listener 1884 INADDR_ANY
autosave_interval 0
keepalive_interval 2
