pastcompute/sentrifarm/base-station/sx1276/bp_sx1276_test1.cpp

#include "sx1276.hpp"
#include "spi_factory.hpp"
#include "misc.h"
#include <boost/shared_ptr.hpp>
#include <boost/format.hpp>
#include <iostream>

using boost::shared_ptr;
using boost::format;
using std::cout;

inline std::string safe_str(const char *m)
{
  std::string result;
  for (; *m; ) { char c = *m++; result += iscntrl(c) ? '.' : c; }
  return result;
}

int main(int argc, char* argv[])
{
  if (argc < 2) { fprintf(stderr, "Usage: %s <spidev>", argv[0]); return 1; }

  shared_ptr<SPI> spi = SPIFactory::GetInstance(argv[1]);
  if (!spi) { PR_ERROR("Unable to create SPI device instance\n"); return 1; }

  // Pass a small value in for RTL-SDK spectrum analyser to show up
  unsigned inter_msg_delay_us = 200000;
  if (getenv("BEACON_INTERVAL")) { inter_msg_delay_us = atoi(getenv("BEACON_INTERVAL")); }

  Misc::UserTraceSettings(spi);

  // TODO work out how to run without powering off / resetting the module

  usleep(100);
  SX1276Radio radio(spi);

  cout << format("SX1276 Version: %.2x\n") % radio.version();

  spi->AssertReset();

  radio.ChangeCarrier(918000000);
  radio.ApplyDefaultLoraConfiguration();
  cout << format("Check read Carrier Frequency: %uHz\n") % radio.carrier();

  if (radio.fault()) return 1;

  char msg[] = "Hello, World! XXXXXX\n";
  printf("Beacon message: '%s'\n", safe_str(msg).c_str());
  printf("Predicted time on air: %fs\n", radio.PredictTimeOnAir(msg));

  int total = 0;
  int faultCount = 0;
  while (true) {
    total++;
    snprintf(msg, sizeof(msg), "Hello, World! %6d\n", total);
	
    if (radio.SendSimpleMessage(msg)) { printf("."); fflush(stdout); radio.Standby(); usleep(inter_msg_delay_us); continue; }
    radio.Standby();
    printf("\n");
    faultCount++;
    PR_ERROR("Fault on send detected: %d of %d\n", faultCount, total);
    printf("Beacon message: '%s'\n", safe_str(msg).c_str());
    printf("Predicted time on air: %fs\n", radio.PredictTimeOnAir(msg));
    radio.reset_fault();
    spi->AssertReset();
	  radio.ChangeCarrier(918000000);
    radio.ApplyDefaultLoraConfiguration();
    usleep(500000);
  }
  return 1;
}
