pastcompute/sentrifarm/attic/experiments/esp8266/include/main.h

#ifndef MAIN_H__
#define MAIN_H__

/*
   !!
	DO NOT USE MALLOC
   !!
  
   USE MEM_ALLOC INSTEAD (MEM_ALLOC/MEM_REALLOC/MEM_FREE)
   which are defined in lwip/mem.h and defined as PvPort*...
   or os_*alloc()...
*/

#endif // _MAIN_H
