pastcompute/sentrifarm/(commit log)

2015-03-28 ESP + DHT : should be working, but doesnt due to electrical issues
    [dht_esp8266.ino]
2015-03-28 Resturcture sensor code hierarchy
2015-03-28 Port fixes from minimal
    [hostname.c, main.c]
2015-03-28 Track .config for this specific application
2015-03-29 Working TCP push ds18b20 temperature
2015-03-29 Error as json as well
    [sentrifarm.c]
2015-04-05 A demo circuit for ESP monitoring
    [esp01-simple_temp.fzz]
2015-04-05 Preliminary circuit for solar performance monitor
    [charge_monitor.fzz]
2015-04-05 Tidy arduino code
2015-04-10 Solar logging runs
    [first-logging-run.ods, second-logging-run.ods]
2015-04-15 Mostly implement draft sensor code state machine, ready to hook up to sensor and try with solar panel
2015-04-16 Latest solar log data
    [third-logging-run.ods]
2015-04-24 Start experiment of using digispark as a USB SPI bridge for accessing SX1276
2015-04-25 Test that demonstrates failed wifi after deep sleep wakeup
    [test_reassoc_after_sleep.c]
2015-04-28 Base stattion prototype: carambola with i2c pressure sensor and RTC, and SPI for LoRa
2015-04-28 Forgot the ground sensor schematic
    [esp01-ground-sensor-prototype0-threshold.fzz]
2015-04-29 SPI working
2015-05-03 Tested working SPI to sx1276 on carambola using ar933x SPI
2015-05-11 Schematic and PCB board for Carambola2 inAir9 I/O shield
    [ioshield.brd, ioshield.sch]
2015-05-12 Schematics as provided to OshPark
    [ioshield.brd, ioshield.sch]
2015-05-14 Decouple bus pirate powerup from SPI config
2015-05-18 Fix test program running on carambola
    [bp_sx1276_test1.cpp, buspirate_spi.cpp, spidev_spi.cpp]
2015-05-19 First cut at basic receive functionality
2015-05-19 Tested receive, Works on Linux SPI, bus pirate is flaky
2015-05-19 Code to trace through state changes
2015-05-20 Remove inadvertent IRQ flag setting error
    [sx1276.cpp]
2015-05-20 Seems to be reliably receving beacon. Some tidy up required, possibly issue with BP reset
    [bp_sx1276_test1.cpp, buspirate_binary.c, buspirate_binary.h, buspirate_spi.cpp, sx1276.cpp]
2015-05-20 Reset frequency on power off
    [bp_sx1276_test1.cpp]
2015-05-24 Big tidy up, decouple SPI from platform (gpio, reset)
    [buspirate_binary.c, buspirate_binary.h, buspirate_spi.cpp, buspirate_spi.hpp, spi.hpp, spidev_spi.cpp, spidev_spi.hpp, sx1276.cpp]
2015-05-24 Fixup uninitialised variables and other problems.
    [buspirate_spi.cpp, buspirate_spi.hpp, spidev_spi.cpp, spidev_spi.hpp, sx1276.cpp, sx1276_platform.cpp, sx1276_test1_rx.cpp, sx1276_test1_tx.cpp]
2015-06-03 Fixes to build mosquitto and c-ares for openwrt
    [util.hpp]
2015-06-04 Import libsocket into CMakeLists and example of UDP connecting with RSMB broker bridge
    [fifo_mqttsn_bridge.cpp, sx1276_mqttsn_bridge.cpp]
2015-06-06 Swap SCL, SDA due to PCB error
2015-06-06 LED is on GPIO15. Also add beeper module
2015-06-06 Turn on DIO LED on valid header
2015-06-06 First cut at sx1276 mqttsn bridge
2015-06-07 Fix stupid locking error
    [sx1276_mqttsn_bridge.cpp]
2015-06-07 Messages flowing now, just need to sort out RSMB. Probably we should drop the ACK code, because getting cross inteference and MQTT-SN does it anyway Also fixed spurious byte which was causing problem
    [sx1276.cpp, sx1276.hpp, sx1276_mqttsn_bridge.cpp]
2015-06-21 Platformio working hello world on ESP. Todo: teensy
2015-06-21 Restructure to prepare to support raspberry pi target as well
2015-06-21 Raspberry pi image support
2015-06-23 SPI device for raspi
2015-06-27 Schematic and PCB for the shield adaptor
    [ioshield.brd, ioshield.sch]
2015-06-27 Circuit PDFs
2015-06-28 Attempt to use sx1272 as arduino lib no good, too large for icache and a PITA to fix. Time to (re)write my own
    [beacon.ino]
2015-06-28 Code for SX1276 beacon on esp8266/teensy/arduino
2015-07-01 First cut at arduino beacon receiver
2015-07-11 Import mqtt-sn-arduino forked from https://bitbucket.org/MerseyViking/mqtt-sn-arduino/src commit 0d00d95261319c40ffa19d81f33b3bc3aa767be7
2015-07-11 Tweak up arduino mqtt sn fork to work how we need it
2015-07-11 Rough cut of SX1276 MQTTSN node on Arduino / Teenst / ESP8266
2015-07-11 Keep radio warm when receiving repeatedly, otherwise we loose data
    [sx1276.cpp]
2015-07-11 Rounding error intermittent tx timeout
    [sx1276.cpp]
2015-07-22 Read i2c pressure / temp / ADC hack test. A2c maybe junk, could be because I havent soldered the address jumpers to ground
2015-08-02 Major restructure and cleanup of directories
    [charge_monitor.fzz, esp01-ground-sensor-prototype0-threshold.fzz, esp01-simple_temp.fzz, first-logging-run.ods, second-logging-run.ods, third-logging-run.ods]
2015-08-17 Fix compiler warning and PTOA for the bridge
    [sx1276.cpp, sx1276.hpp, sx1276_mqttsn_bridge.cpp]
2015-08-19 Remove SPI read/write from ESP8266 ICACHE flash to see if it helps performance
2015-08-19 Workaround issues with i2c failing after radio ops
    [node.ino]
2015-08-19 Fix excess payload length on tx, maybe leading to missed data
    [sx1276.cpp]
2015-08-19 Bump symbol timeout to 366 same as teensy side
2015-08-23 Fix issues with raspberry pi build
2015-08-26 Tidy of new leaf node firmware, ready to rework the MQTTSN loop
    [leaf.ino]
2015-08-29 Improve i2c debugging
2015-08-29 Revert to QOS0, msgs seem to get stuck on other side
    [leaf.ino]
2015-08-29 Hack around some mqtt-sn issues. More refactoring will be needed down the track I think
    [leaf.ino]
2015-08-30 Need date_time for printing timestamp in rx test
2015-08-30 Print time in rx test, and use spinner instead of x's to indicate working
2015-08-30 Fix spurious ADC channel problem
2015-09-06 Start improving OpenWRT build with MQTT programs
    [sentrifarm-rsmb-config.txt]
2015-09-12 Fix teensy build
2015-09-13 Teensy fixes and function attrs for ESP8266
    [leaf.ino]
2015-09-13 Added beacon RX mode for ESP / teensy
2015-09-13 TeensyLC working 'deep' sleep
2015-09-13 Fix issue with puback
    [leaf.ino]
2015-09-14 Use beacon mode jumper to reset boot count
    [leaf.ino]
2015-09-15 Set high power mode from environment
2015-09-15 Allow trace debug enabled from environment for the bridge, and ensure symbol timeout is activated in test rx
2015-09-15 Fix incorrect coding rate setting
    [sx1276.cpp]
2015-09-15 Fix beacon mode for ESP8266
    [leaf.ino]
2015-09-19 Read 1-wire thermometer in base station
2015-09-19 Issues with i2c on teensy
    [leaf.ino]
2015-09-19 Add humidity sensor to paddock node.
2015-09-19 Slash and burn strings to fit into teensy memory
    [leaf.ino]
2015-09-19 More belt tightening to get it going in the ESP01 again
    [leaf.ino]
2015-09-20 Check radio presence when testing without carrier board
2015-12-31 Fix beacon/log mode jumper selection
    [leaf.ino]
2015-12-31 Fix issues with humidity sensor
    [dht-test.ino, leaf.ino]
2015-12-31 Fix issues with ADC
    [adc-test.ino]
2016-01-01 Fix random typos
    [sentrifarm-rsmb-config.txt]
2016-03-25 Raspberry pi fixes
2016-03-25 Add a shim to reset the RTC in the MCU
    [leaf.ino]
